Actronix09/SeguidorLinea_Brazo/Imagenes/Robot Render.png

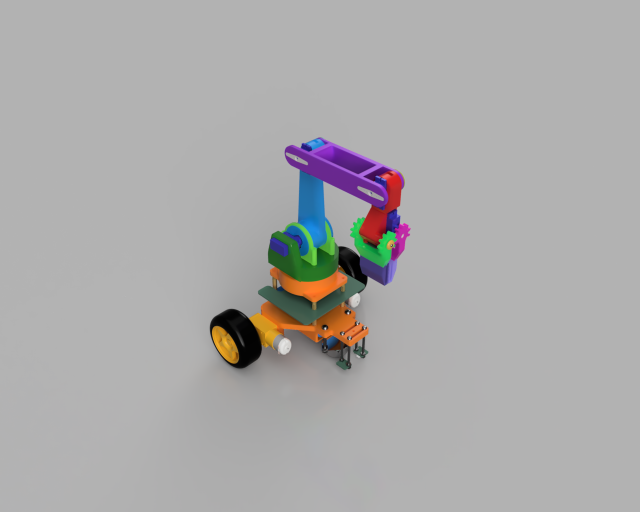
Imagenes/Robot Render.png
