Actronix09/SeguidorLinea_Brazo/Documentos/Piezas Seguidor Linea.stl

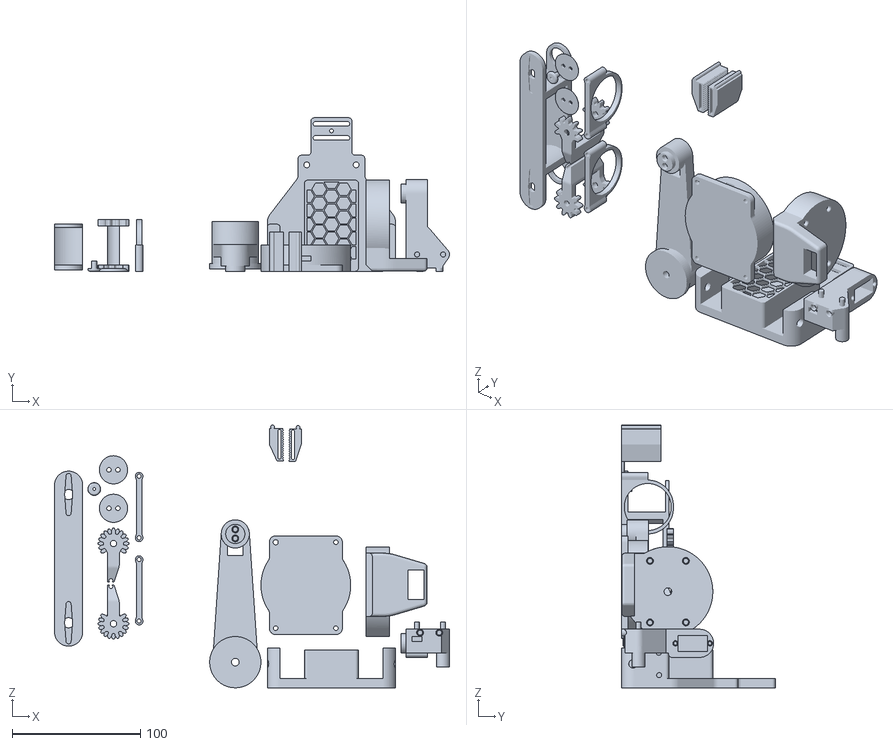
[picture p8: CAD file, 2026-05-11]
Documentos/Piezas Seguidor Linea.stl
308.1 x 119.8 x 205.1
