Actronix09/SeguidorLinea_Brazo/(list of files, cad)

Other CAD files:
Codigo/signals_auto_stripped.stp
Codigo/signals.stp
