Actronix09/SeguidorLinea_Brazo/Documentos/PCB V3.pdf

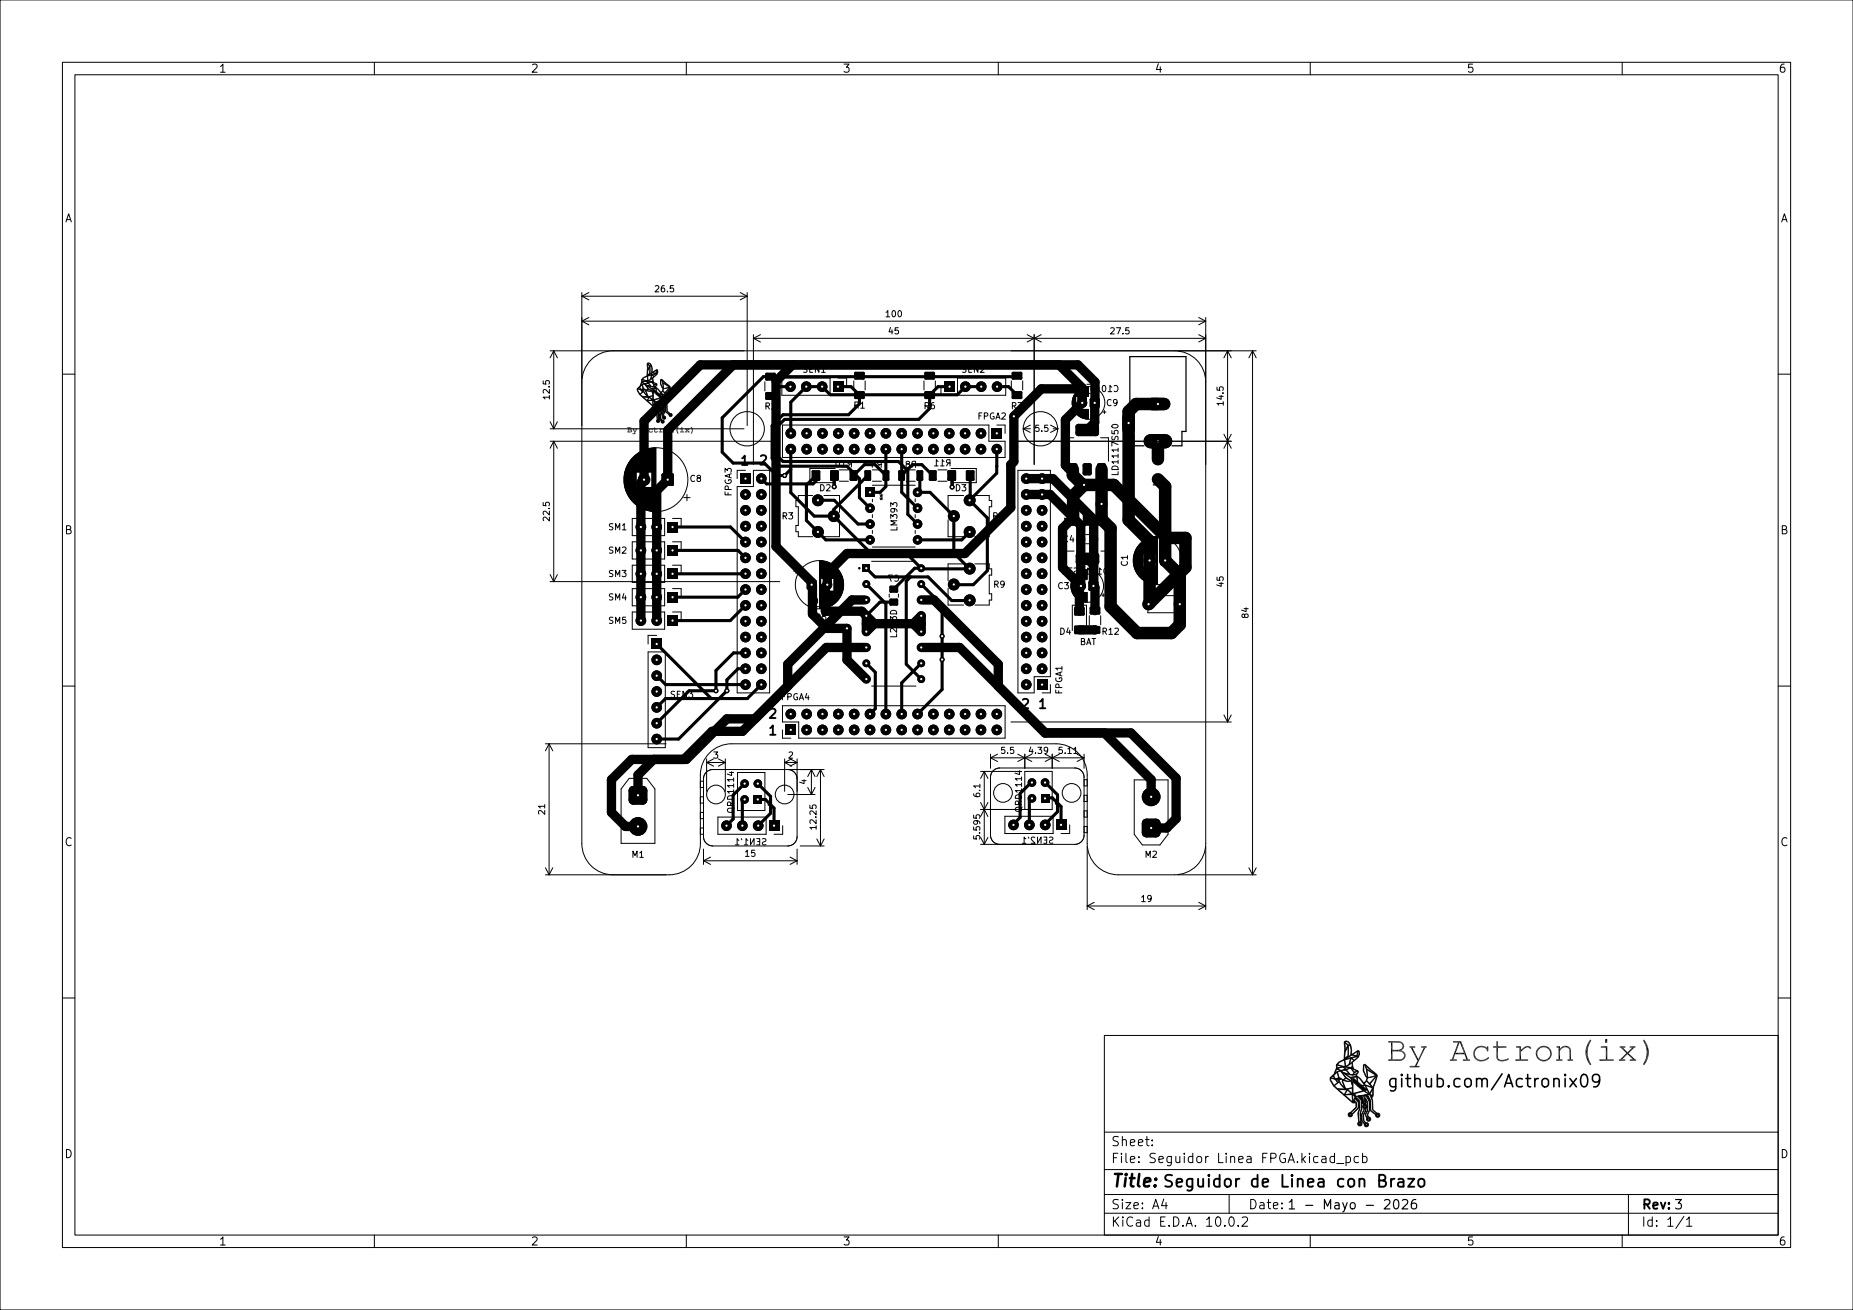
[picture p9: page 1]
