Actronix09/SeguidorLinea_Brazo/Documentos/SCH V3.pdf

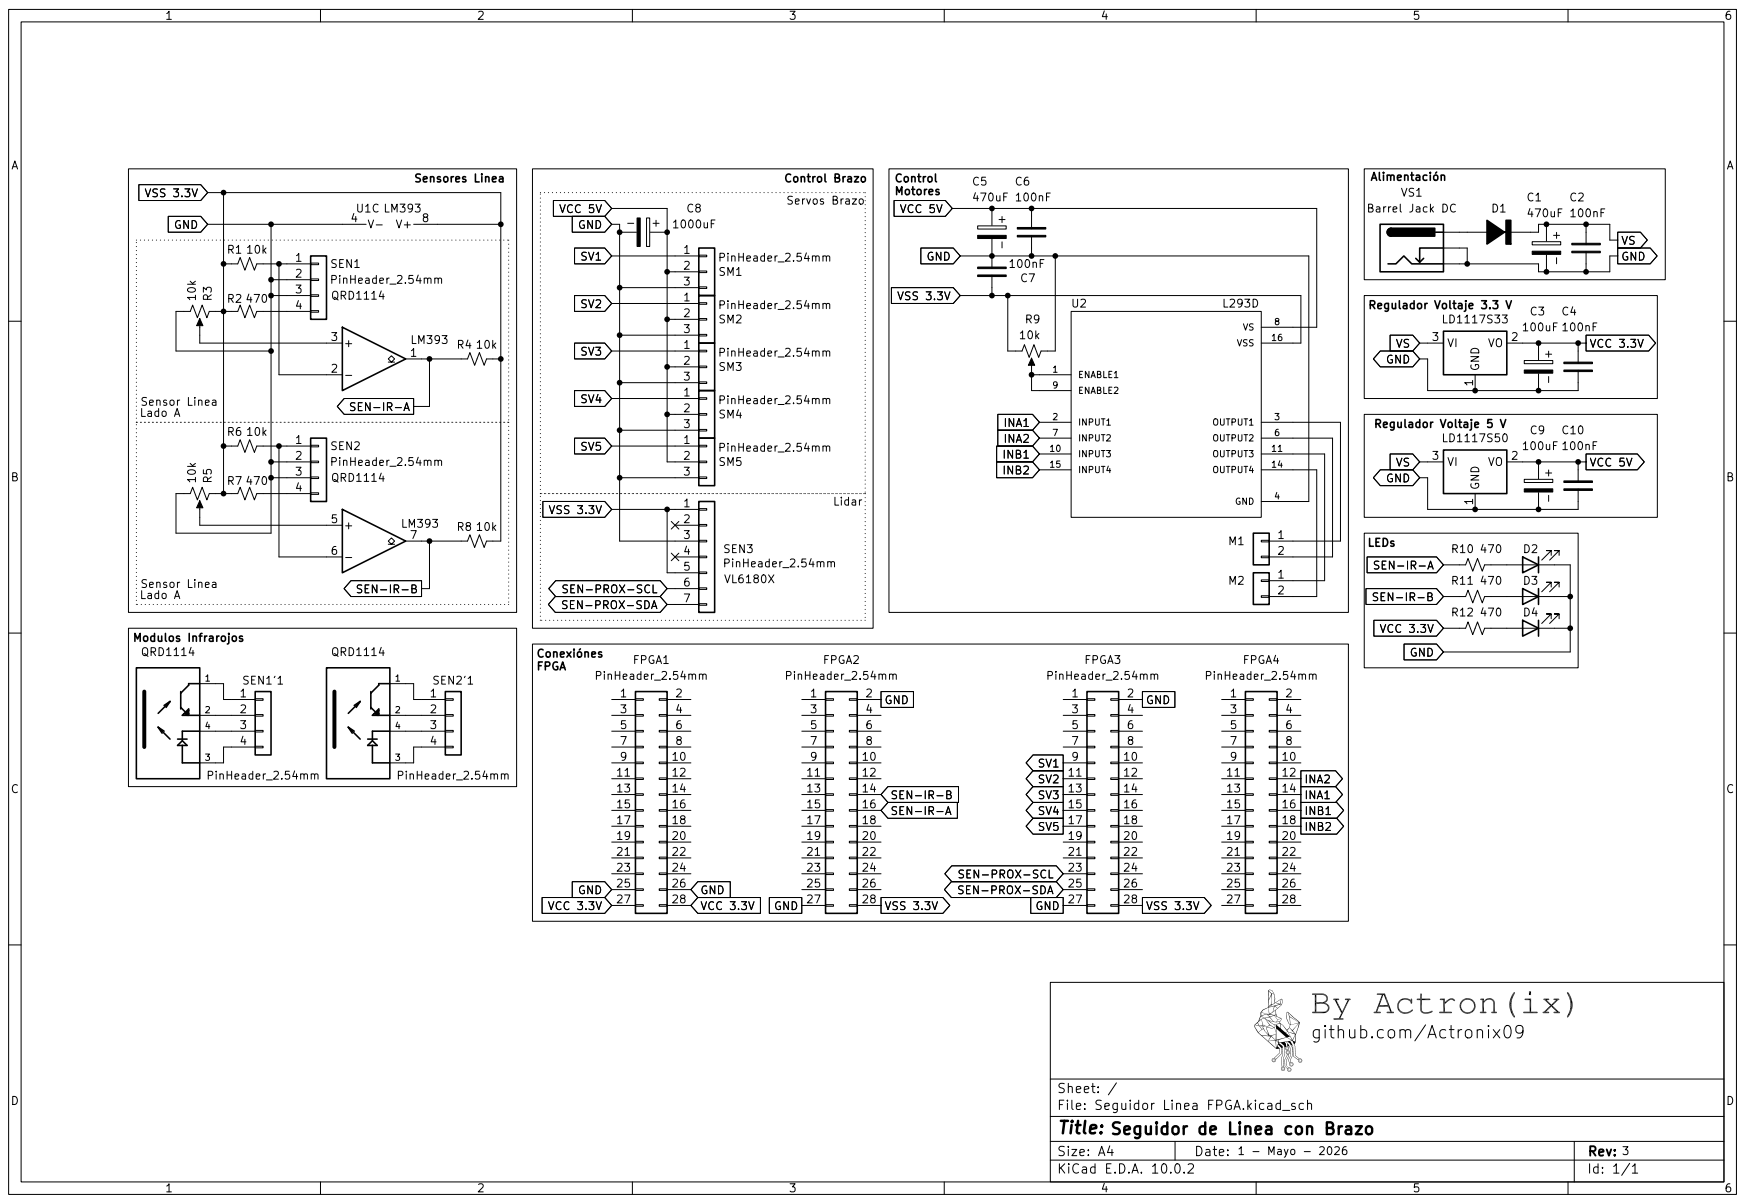
[picture p10: page 1]
