Actronix09/SeguidorLinea_Brazo/Documentos/Seguidor Linea Planos.pdf

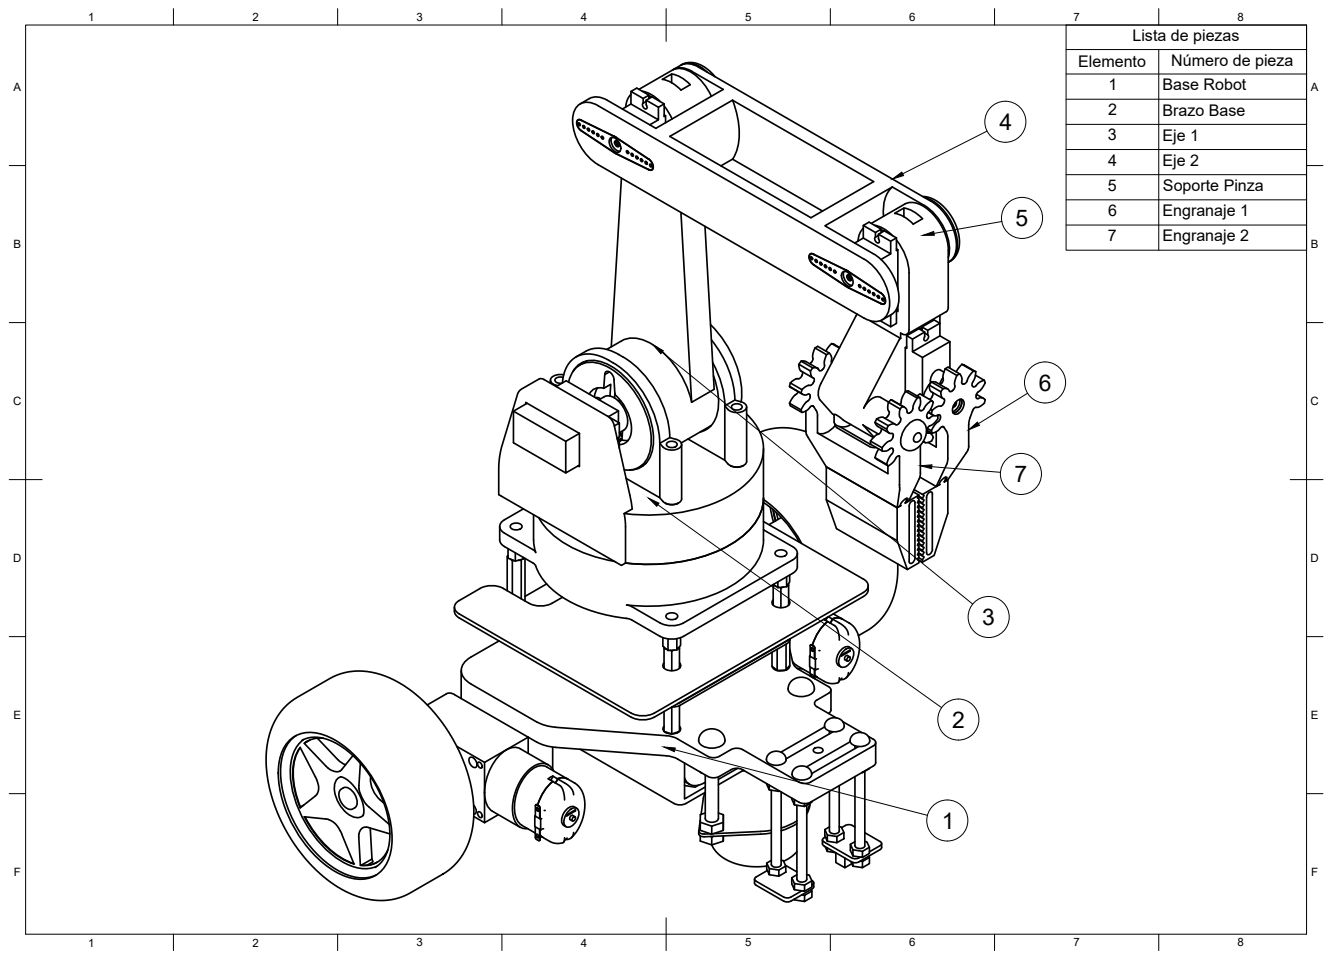
[picture p11: page 1]
8 BCDEF; ABCDEF; Elemento; Número de pieza 1; Base Robot 2; Brazo Base 3; Eje 1 4; Eje 2 5; Soporte Pinza 6; Engranaje 1 7; Engranaje 2 12

Lista de piezas

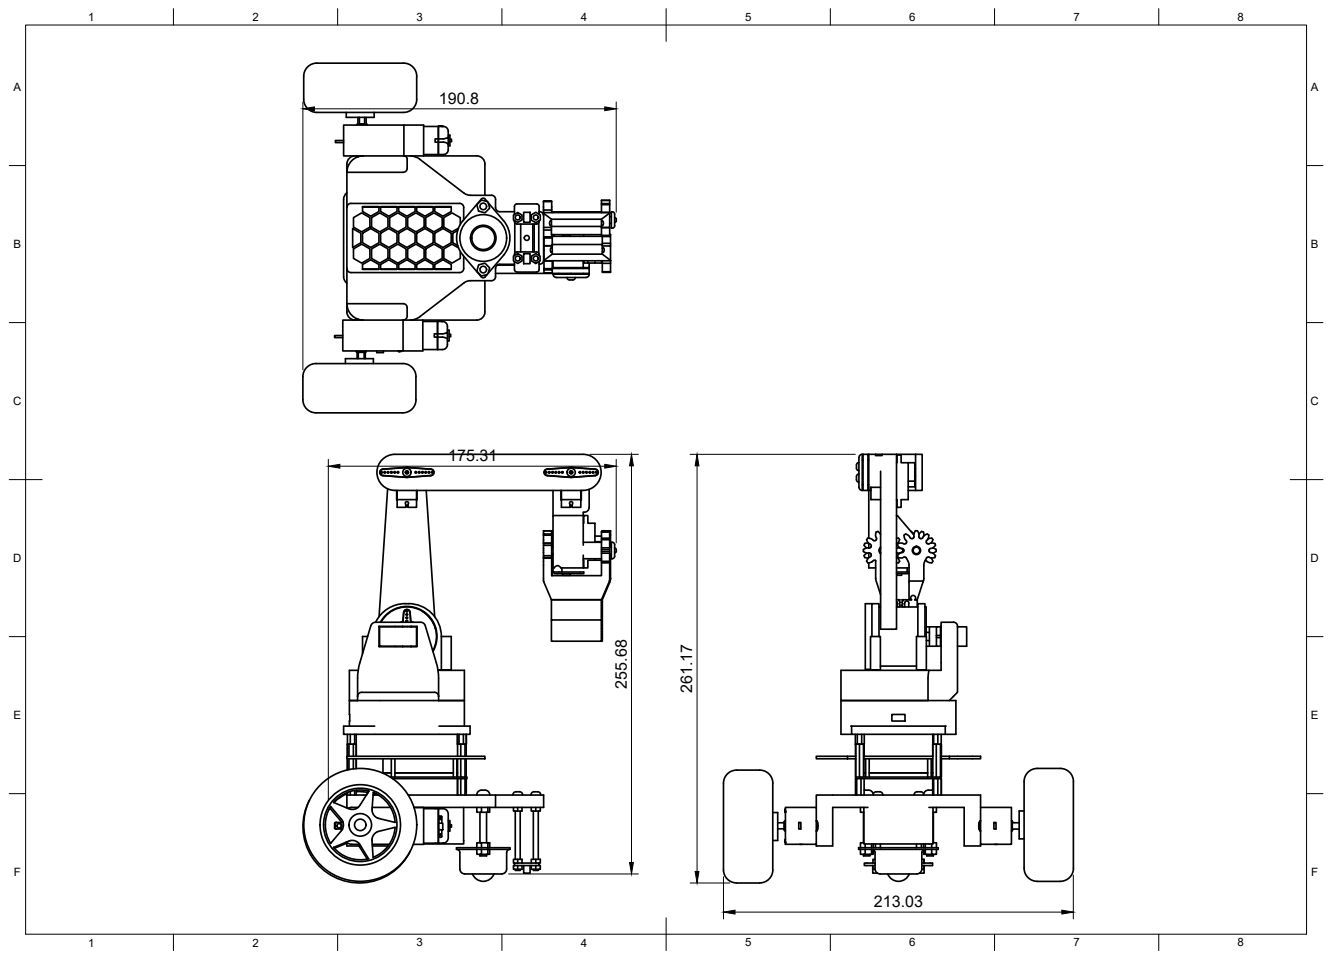
[picture p12: page 2]
8 BCDEF; ABCDEF 255.68

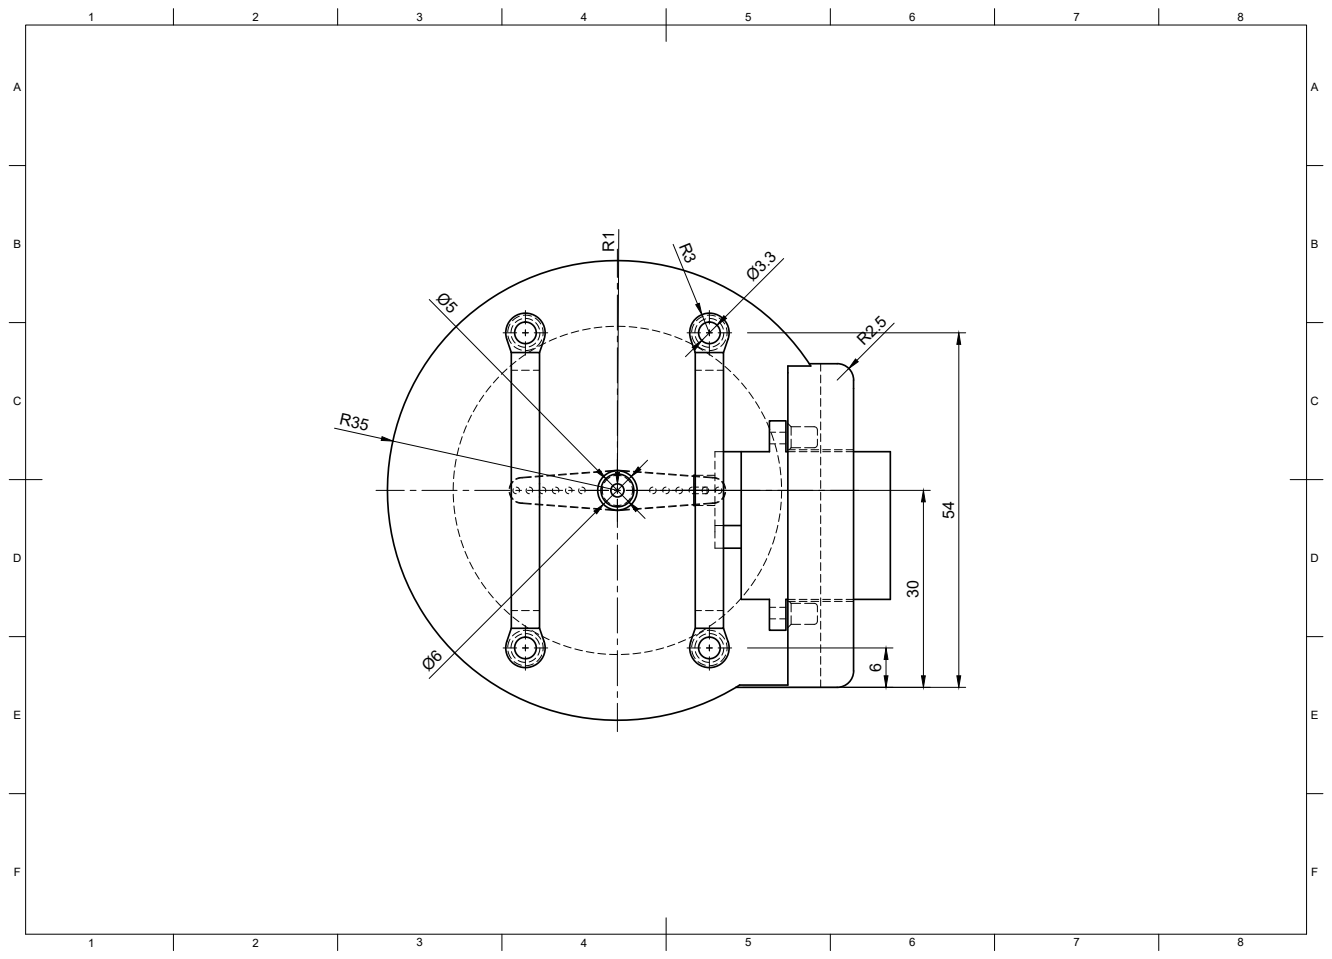
[picture p13: page 3]
8 BCDEF; ABCDEF 54 Ø3.3 Ø5 Ø6

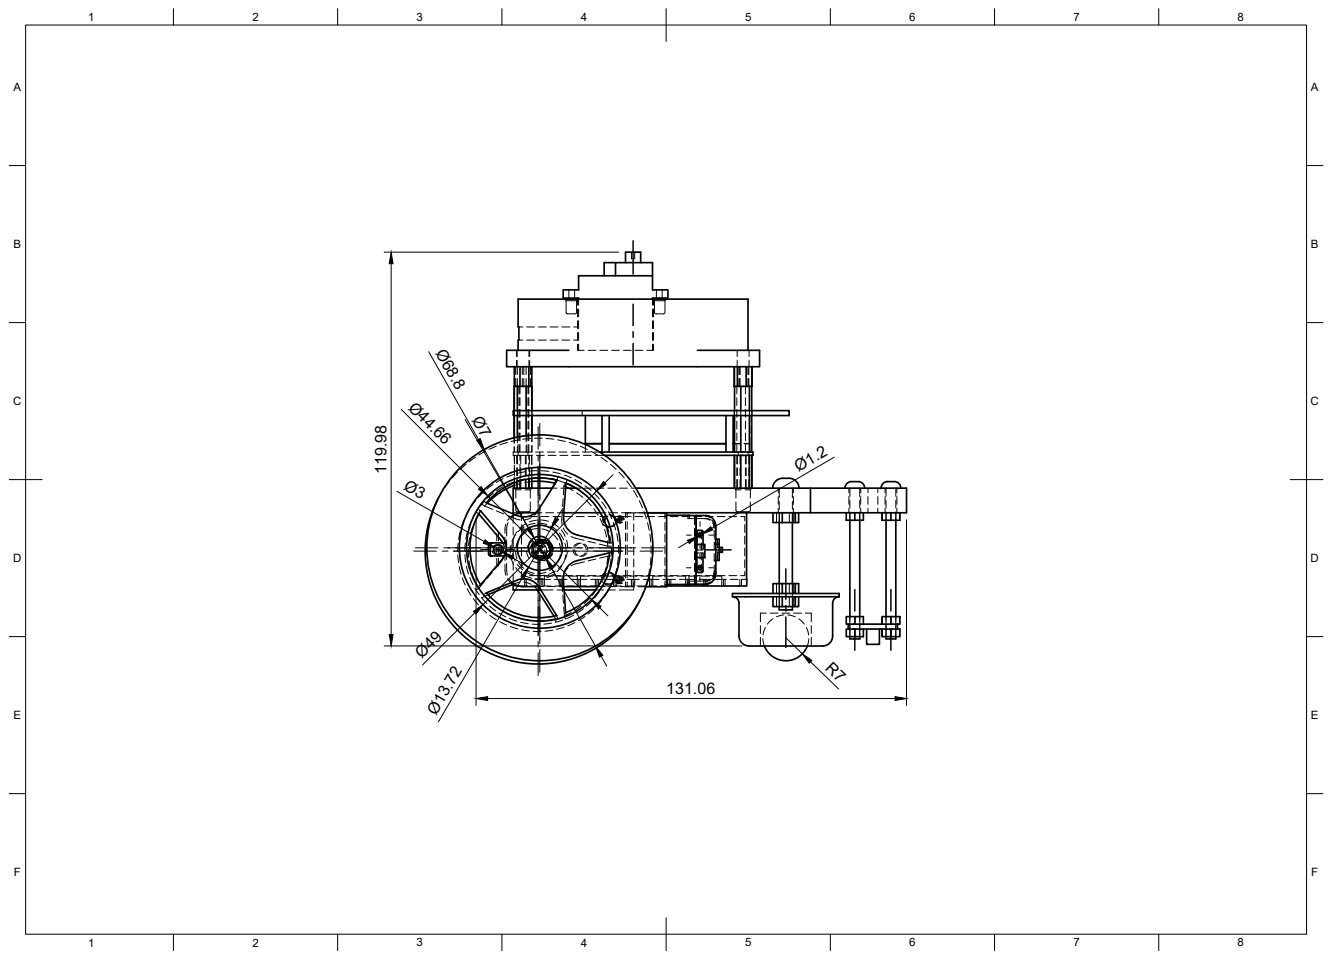
[picture p14: page 4]
8 BCDEF; ABCDEF

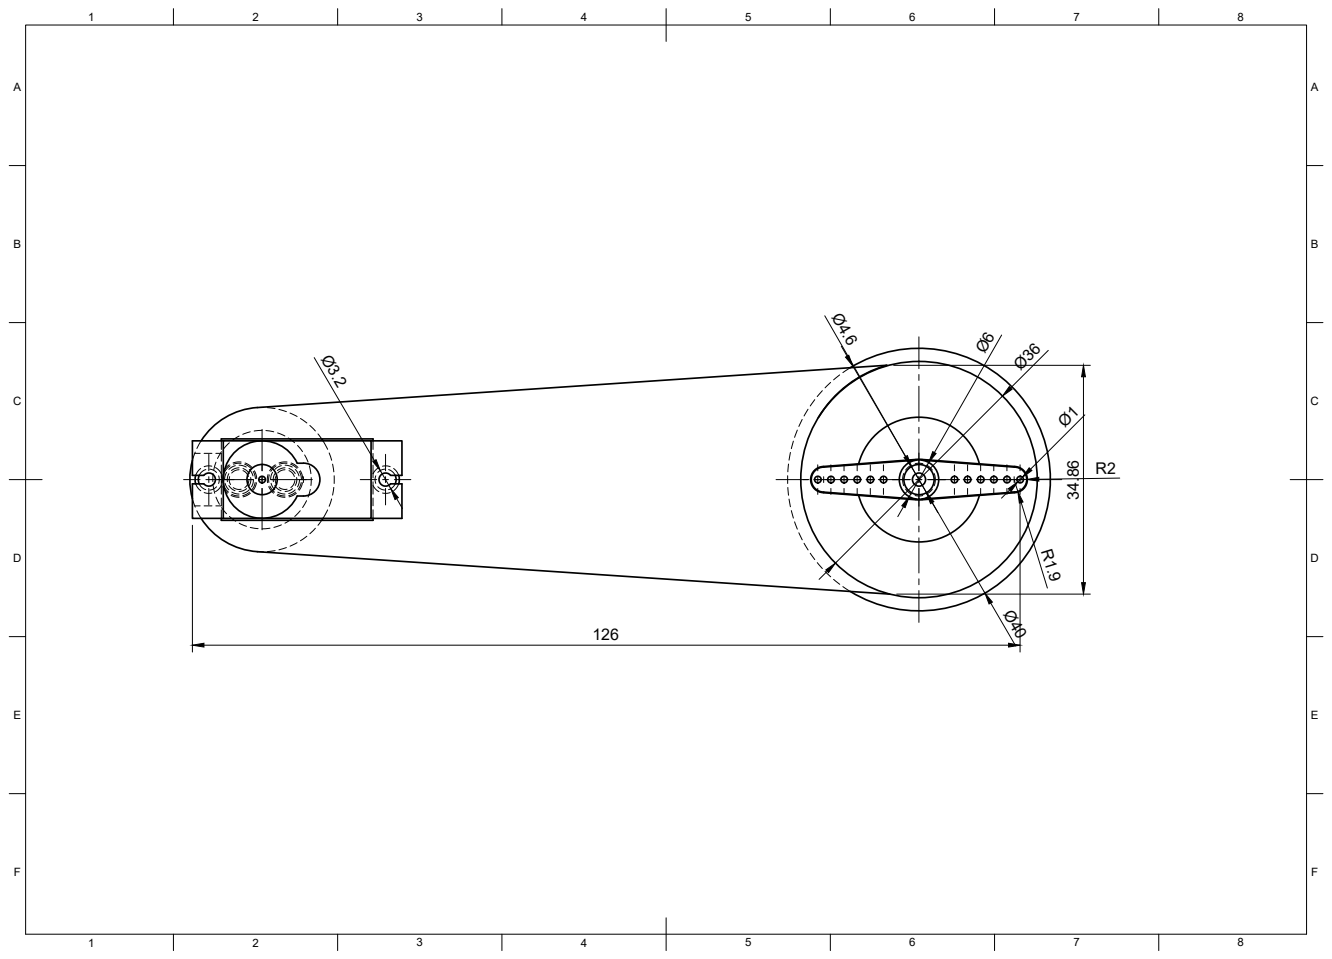
[picture p15: page 5]
8 BCDEF; ABCDEF

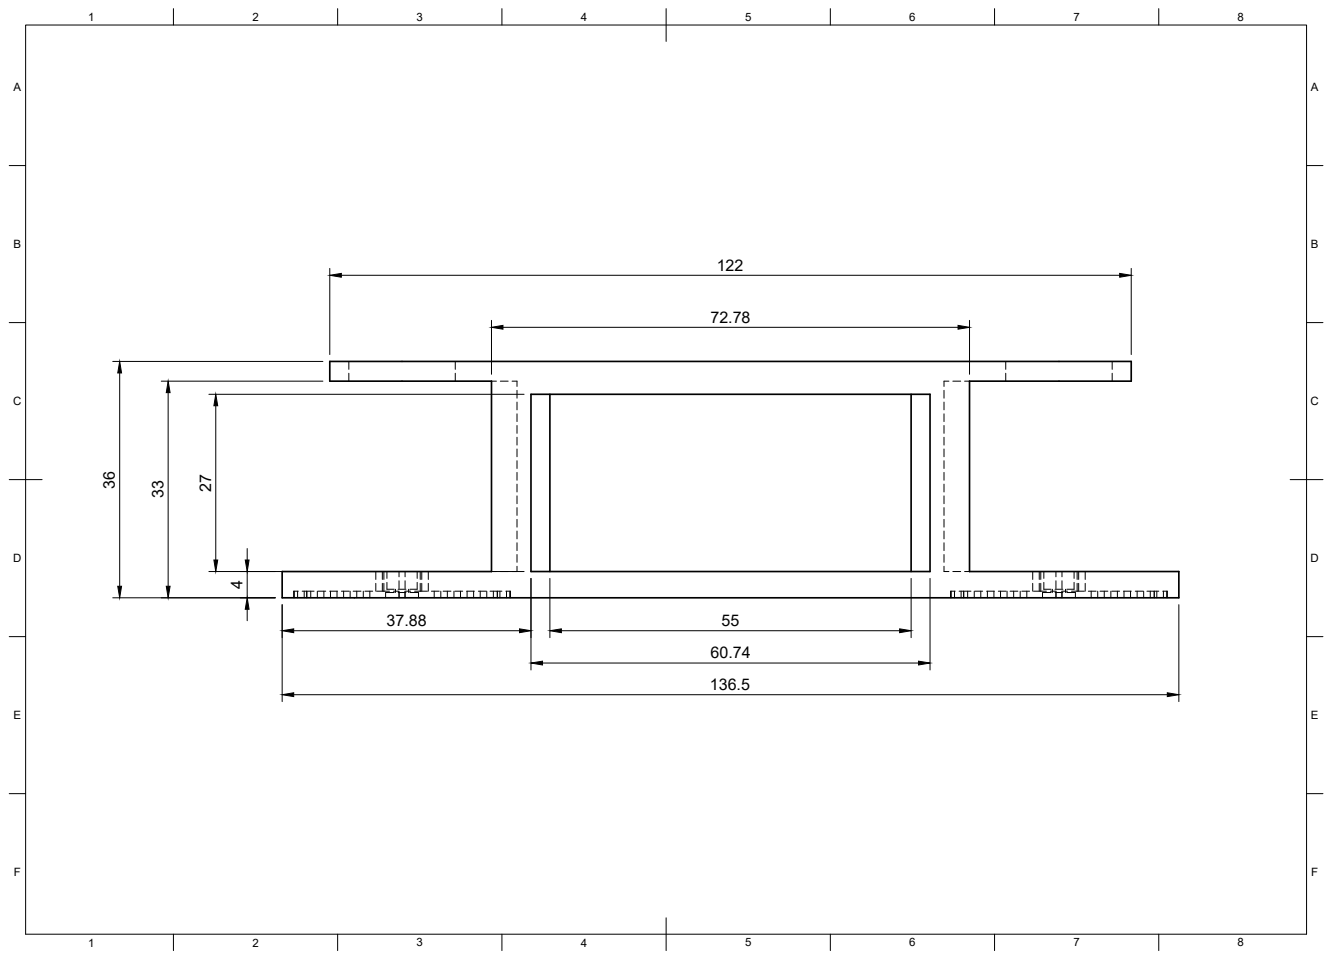
[picture p16: page 6]
8 BCDEF; ABCDEF

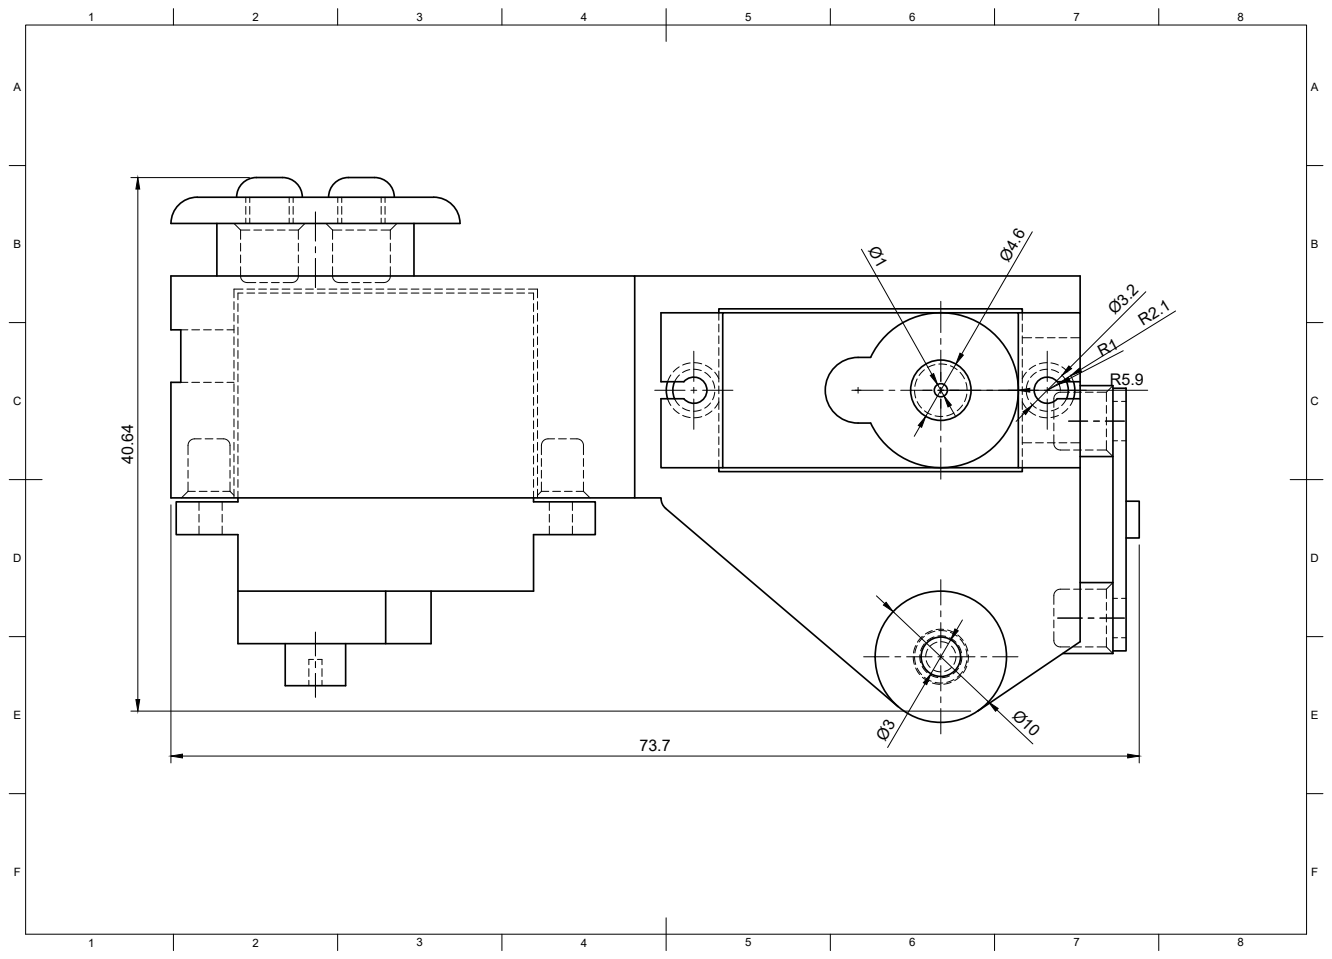
[picture p17: page 7]
8 BCDEF; ABCDEF

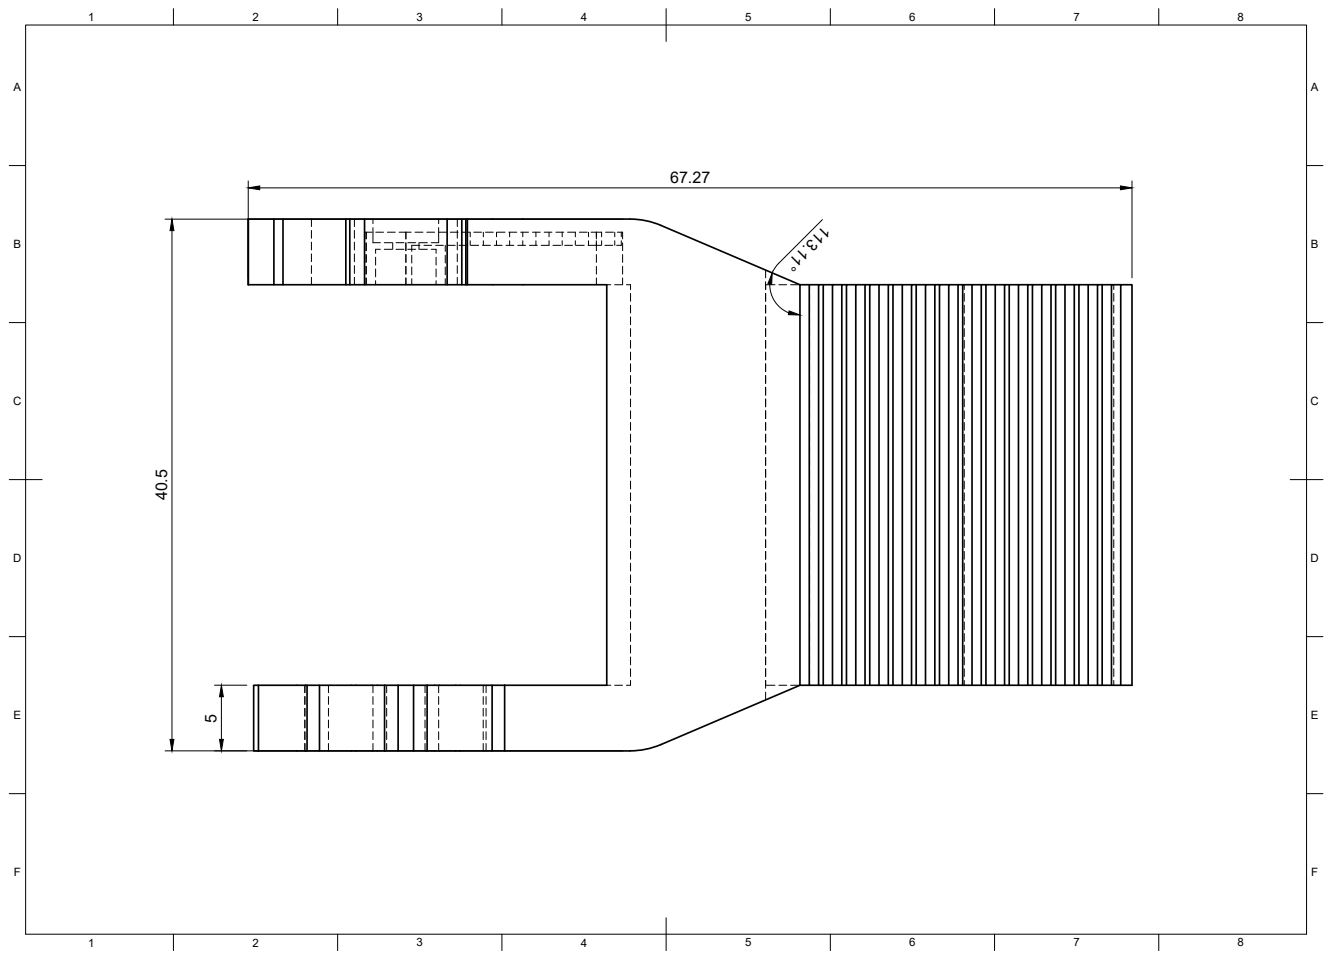
[picture p18: page 8]
8 BCDEF; ABCDEF

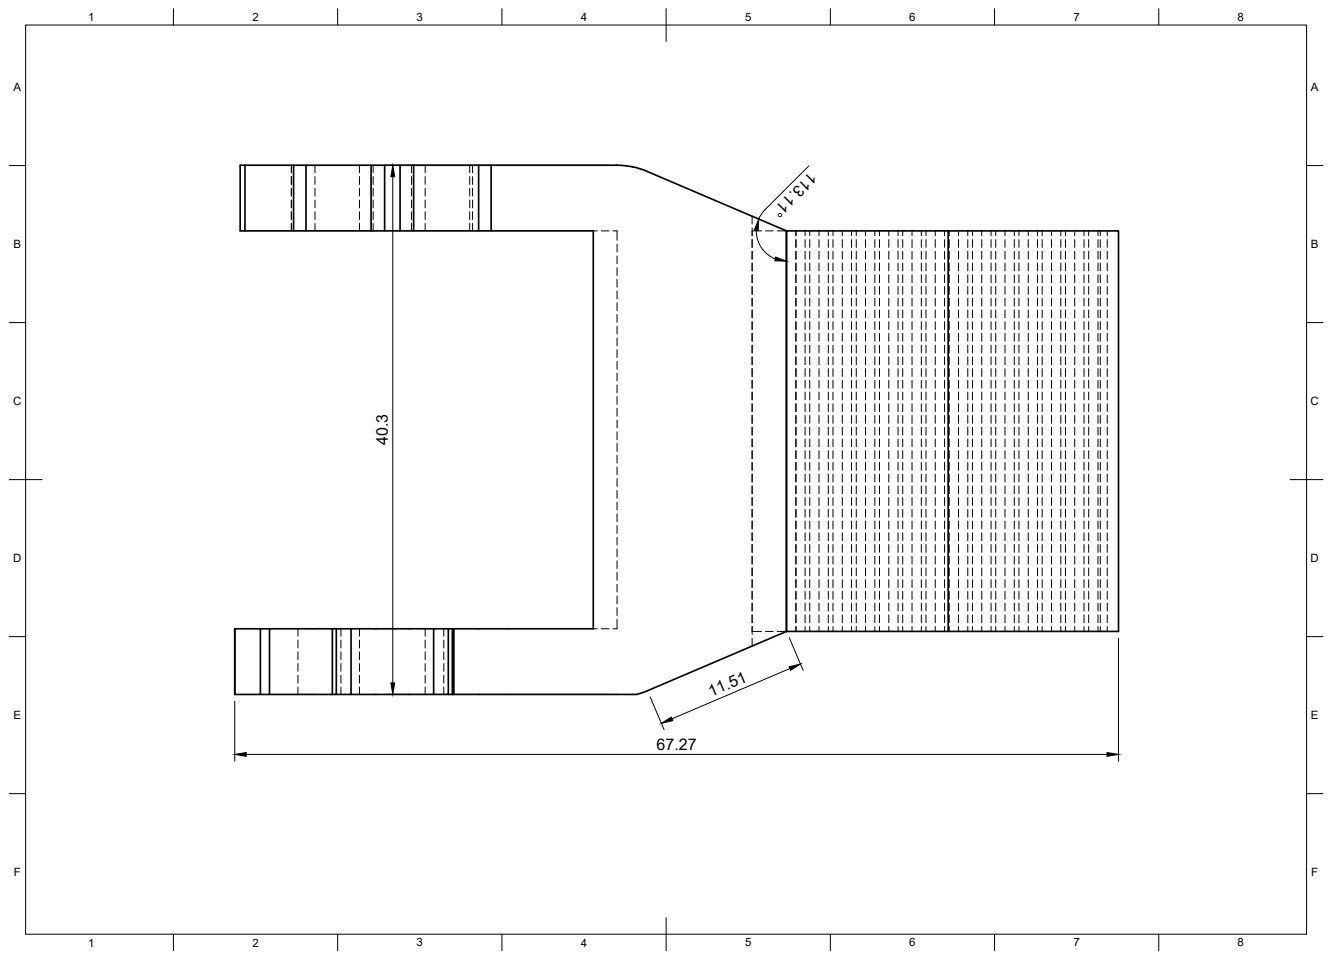
[picture p19: page 9]
8 BCDEF; ABCDEF 40.3
