Actronix09/SeguidorLinea_Brazo/Codigo/SeguidorLinea_Brazo.vhd

-- ============================================================================
-- SeguidorLinea_Brazo - TOP de Sísifo (ETAPA 2, integración final)
-- FPGA: Cyclone II EP2C5T144C7 | Placa: RZ-EasyFPGA A2.2 | Reloj: 50 MHz
-- ----------------------------------------------------------------------------
-- Sísifo sigue una pista cerrada en loop y, en cada zona (cuadrado negro con
-- línea blanca), alterna según el estado de acarreo:
--   - SIN objeto -> dispara el LIDAR (buscar + agarrar) y queda en HOLD.
--   - CON objeto -> deposita (gira la base a phi=90, extiende, abre garra).
--
-- Cableado (ver plan Etapa 2):
--   QRD izq/der -> MaquinaEstados --(PWM A1/A2/B1/B2)--> L293 -> 2 motores DC
--                       │  ▲ has_object, arm_ready
--          start_scan ──┘  │  trigger_drop
--                       ▼  │
--     LIDAR (escáner) --cmd_*/min_*/found/scan_done/scan_active--> grab_ctrl
--          │ I2C VL53L0X                                              │
--          ▼                                                         ▼
--                  grab_ctrl --(phi,t1,t2,t3,grip muxeados)--> [180−t1] -> polarPWM -> 5 servos
--
-- El top sólo aplica la inversión de theta1 (servo montado al revés) antes de
-- polarPWM y cablea motores / sensores / LEDs. reset activo BAJO (PIN_144).
-- ============================================================================

library IEEE;
use IEEE.STD_LOGIC_1164.ALL;
use IEEE.NUMERIC_STD.ALL;

entity SeguidorLinea_Brazo is
    port (
        clk          : in    std_logic;                 -- PIN_17
        reset        : in    std_logic;                 -- PIN_144, activo bajo
        i2c_scl      : out   std_logic;                 -- PIN_142
        i2c_sda      : inout std_logic;                 -- PIN_136
        servo_phi    : out   std_logic;                 -- PIN_118
        servo_theta1 : out   std_logic;                 -- PIN_122
        servo_theta2 : out   std_logic;                 -- PIN_126
        servo_theta3 : out   std_logic;                 -- PIN_132
        servo_gripper: out   std_logic;                 -- PIN_134
        sensor_izq   : in    std_logic;
        sensor_der   : in    std_logic;
        motor_a1     : out   std_logic;                 -- PIN_4
        motor_a2     : out   std_logic;                 -- PIN_8
        motor_b1     : out   std_logic;                 -- PIN_31
        motor_b2     : out   std_logic;                 -- PIN_24
        led_1        : out   std_logic;                 -- vida 1 Hz (activo bajo)
        led_2        : out   std_logic;                 -- has_object (activo bajo)
        led_3        : out   std_logic                  -- zona_fallo (activo bajo)
    );
end SeguidorLinea_Brazo;

architecture Behavioral of SeguidorLinea_Brazo is

    component LIDAR
        port (
            clk           : in    std_logic;
            rst           : in    std_logic;
            start_scan    : in    std_logic;
            i2c_scl       : out   std_logic;
            i2c_sda       : inout std_logic;
            scan_active   : out   std_logic;
            cmd_phi       : out   std_logic_vector(7 downto 0);
            cmd_theta1    : out   std_logic_vector(7 downto 0);
            cmd_theta2    : out   std_logic_vector(7 downto 0);
            cmd_theta3    : out   std_logic_vector(7 downto 0);
            cmd_grip      : out   std_logic;
            min_t1        : out   std_logic_vector(7 downto 0);
            min_d         : out   std_logic_vector(15 downto 0);
            min_phi       : out   std_logic_vector(7 downto 0);
            found         : out   std_logic;
            scan_done     : out   std_logic;
            scan_fault    : out   std_logic;
            dbg_meas_tick : out   std_logic
        );
    end component;

    component polarPWM
        port (
            clk         : in  std_logic;
            rst         : in  std_logic;
            phi_in      : in  std_logic_vector(7 downto 0);
            theta1_in   : in  std_logic_vector(7 downto 0);
            theta2_in   : in  std_logic_vector(7 downto 0);
            theta3_in   : in  std_logic_vector(7 downto 0);
            grip_cmd    : in  std_logic;
            pwm_phi     : out std_logic;
            pwm_theta1  : out std_logic;
            pwm_theta2  : out std_logic;
            pwm_theta3  : out std_logic;
            pwm_gripper : out std_logic
        );
    end component;

    signal reset_int : std_logic;

    signal start_scan  : std_logic;
    signal scan_active : std_logic;
    signal scan_done   : std_logic;
    signal found       : std_logic;
    signal scan_fault  : std_logic;
    signal meas_tick   : std_logic;
    signal cmd_phi     : std_logic_vector(7 downto 0);
    signal cmd_theta1  : std_logic_vector(7 downto 0);
    signal cmd_theta2  : std_logic_vector(7 downto 0);
    signal cmd_theta3  : std_logic_vector(7 downto 0);
    signal cmd_grip    : std_logic;
    signal min_t1      : std_logic_vector(7 downto 0);
    signal min_d       : std_logic_vector(15 downto 0);
    signal min_phi     : std_logic_vector(7 downto 0);

    signal trigger_drop : std_logic;
    signal has_object   : std_logic;
    signal arm_ready    : std_logic;
    signal reachable    : std_logic;
    signal phi_in       : std_logic_vector(7 downto 0);
    signal theta1_in    : std_logic_vector(7 downto 0);
    signal theta2_in    : std_logic_vector(7 downto 0);
    signal theta3_in    : std_logic_vector(7 downto 0);
    signal grip_in      : std_logic;

    -- servo theta1 montado invertido: corregido antes de polarPWM
    signal theta1_pwm  : std_logic_vector(7 downto 0);

    signal me_led_estado : std_logic;
    signal me_zona_fallo : std_logic;

begin

    reset_int  <= not reset;
    theta1_pwm <= std_logic_vector(to_unsigned(180 - to_integer(unsigned(theta1_in)), 8));

    u_lidar : LIDAR
        port map (
            clk => clk, rst => reset_int, start_scan => start_scan,
            i2c_scl => i2c_scl, i2c_sda => i2c_sda,
            scan_active => scan_active,
            cmd_phi => cmd_phi, cmd_theta1 => cmd_theta1, cmd_theta2 => cmd_theta2,
            cmd_theta3 => cmd_theta3, cmd_grip => cmd_grip,
            min_t1 => min_t1, min_d => min_d, min_phi => min_phi,
            found => found, scan_done => scan_done, scan_fault => scan_fault,
            dbg_meas_tick => meas_tick
        );

    u_grab : entity work.grab_ctrl
        port map (
            clk => clk, rst => reset_int,
            scan_active => scan_active, scan_done => scan_done, found => found,
            min_t1 => min_t1, min_d => min_d, min_phi => min_phi,
            cmd_phi => cmd_phi, cmd_theta1 => cmd_theta1, cmd_theta2 => cmd_theta2,
            cmd_theta3 => cmd_theta3, cmd_grip => cmd_grip,
            trigger_drop => trigger_drop,
            phi_out => phi_in, theta1_out => theta1_in, theta2_out => theta2_in,
            theta3_out => theta3_in, grip_out => grip_in,
            has_object => has_object, arm_ready => arm_ready, reachable => reachable
        );

    u_me : entity work.MaquinaEstados
        port map (
            clk => clk, rst => reset_int,
            sensor_izq => sensor_izq, sensor_der => sensor_der,
            motor_a1 => motor_a1, motor_a2 => motor_a2,
            motor_b1 => motor_b1, motor_b2 => motor_b2,
            led_estado => me_led_estado,
            start_scan => start_scan, trigger_drop => trigger_drop,
            scan_active => scan_active,
            arm_ready => arm_ready, has_object => has_object,
            sensor_err => scan_fault, zona_fallo => me_zona_fallo
        );

    u_pwm : polarPWM
        port map (
            clk => clk, rst => reset_int,
            phi_in => phi_in, theta1_in => theta1_pwm, theta2_in => theta2_in,
            theta3_in => theta3_in, grip_cmd => grip_in,
            pwm_phi => servo_phi, pwm_theta1 => servo_theta1, pwm_theta2 => servo_theta2,
            pwm_theta3 => servo_theta3, pwm_gripper => servo_gripper
        );

    -- activo-bajo: '0' enciende
    led_1 <= not me_led_estado;
    led_2 <= not has_object;
    led_3 <= not me_zona_fallo;

end Behavioral;
