Actronix09/SeguidorLinea_Brazo/(commit log)

2026-05-11 Correcion archivos y REAME
    [Piezas Seguidor Linea.stl]
2026-05-11 Diagrama de Maquina de Estados en README
2026-06-10 LIDAR y Brazo Funcional + Seguidor Doble Modo
    [Piezas Seguidor Linea.stl, Robot.smp_dump.txt, SeguidorLinea_Brazo.smp_dump.txt, _vhdl.psm, behavioral.psm, rtl.psm, signals.stp, signals_auto_stripped.stp]
2026-06-11 Sistema de Seguimiento 2 Modos + Sistema de Estaconamento en Zona
    [SeguidorLinea_Brazo.smp_dump.txt]
2026-06-13 Limpieza General Codigo
    [SeguidorLinea_Brazo.smp_dump.txt]
2026-06-13 Limpiar repositorio: ignorar carpetas generadas y de backup
    - Corregir .gitignore (comillas inválidas en entradas _vcheck/, Codigo_backup_etapa1/, Codigo/_backups/)
    - Sacar del índice: Adafruit_VL53L0X-master/, work/, _backups/, Codigo_backup_etapa1/, _vcheck/
    - Sacar del índice: .vscode/ (config local de IDE)
    [SeguidorLinea_Brazo.smp_dump.txt, _vhdl.psm, behavioral.psm, rtl.psm, signals.stp, signals_auto_stripped.stp, sim.psm]
2026-06-13 Limpieza general
    [Robot.smp_dump.txt, _vhdl.psm, behavioral.psm, rtl.psm, signals.stp, signals_auto_stripped.stp, sim.psm]
2026-06-13 Correcciones de compilacion
2026-06-13 Maquina de Estados Sensores Dentro de Linea V1 (Sin probar)
2026-06-15 Maquina Estados Operacional Sin Zona de Recogida
2026-06-18 Modificaciones pre merge
    [Piezas Seguidor Linea.stl]
